DocMuerde/Iot-aquaculture-platform/docs/manuals/latex/Acuacol/Figuras/desmontaje2.jpeg

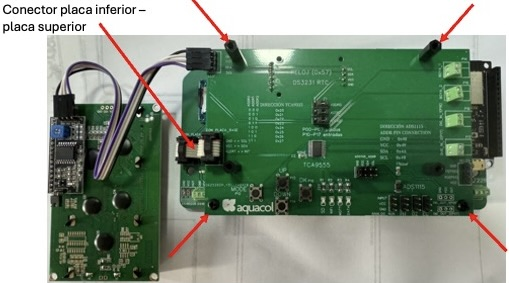
docs/manuals/latex/Acuacol/Figuras/desmontaje2.jpeg
