DocMuerde/Iot-aquaculture-platform/docs/manuals/latex/Acuacol/Figuras/Modulo_reles.png

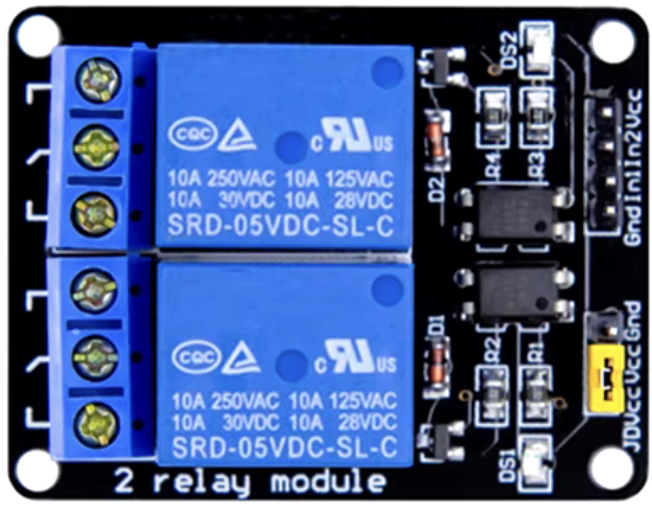
docs/manuals/latex/Acuacol/Figuras/Modulo_reles.png
