DocMuerde/Iot-aquaculture-platform/hardware/pcb1/back1.png

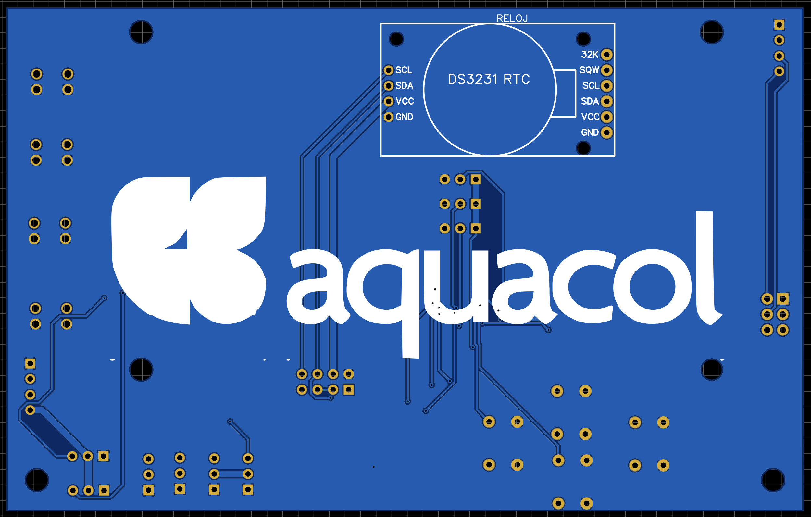
hardware/pcb1/back1.png
