DocMuerde/Iot-aquaculture-platform/hardware/pcb1/front1.png

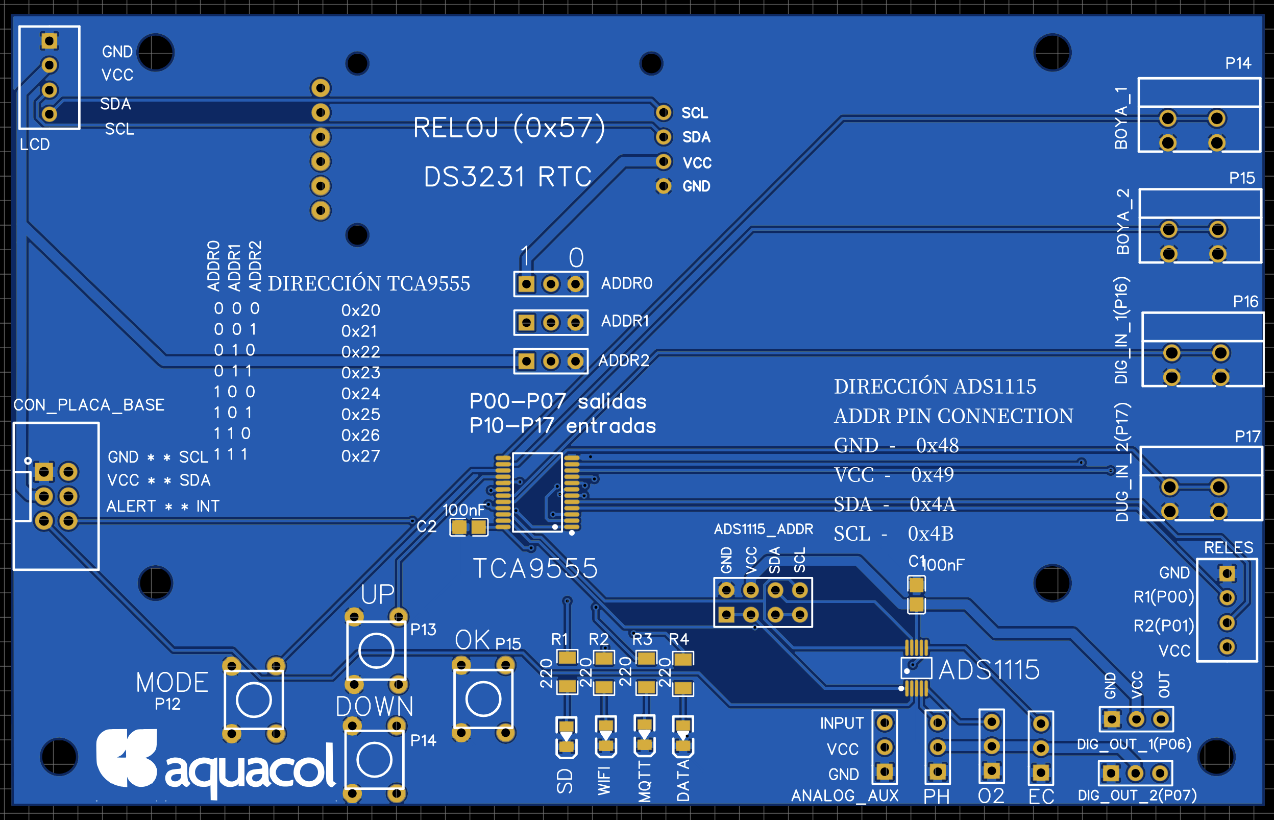
hardware/pcb1/front1.png
