DocMuerde/Iot-aquaculture-platform/hardware/pcb2/back2.png

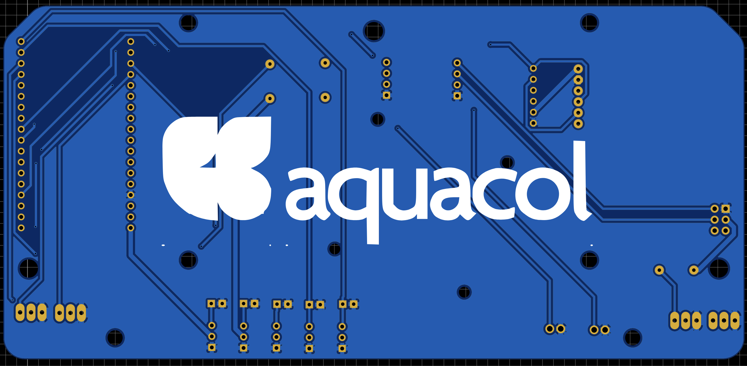
hardware/pcb2/back2.png
