DocMuerde/Iot-aquaculture-platform/hardware/pcb2/front2.png

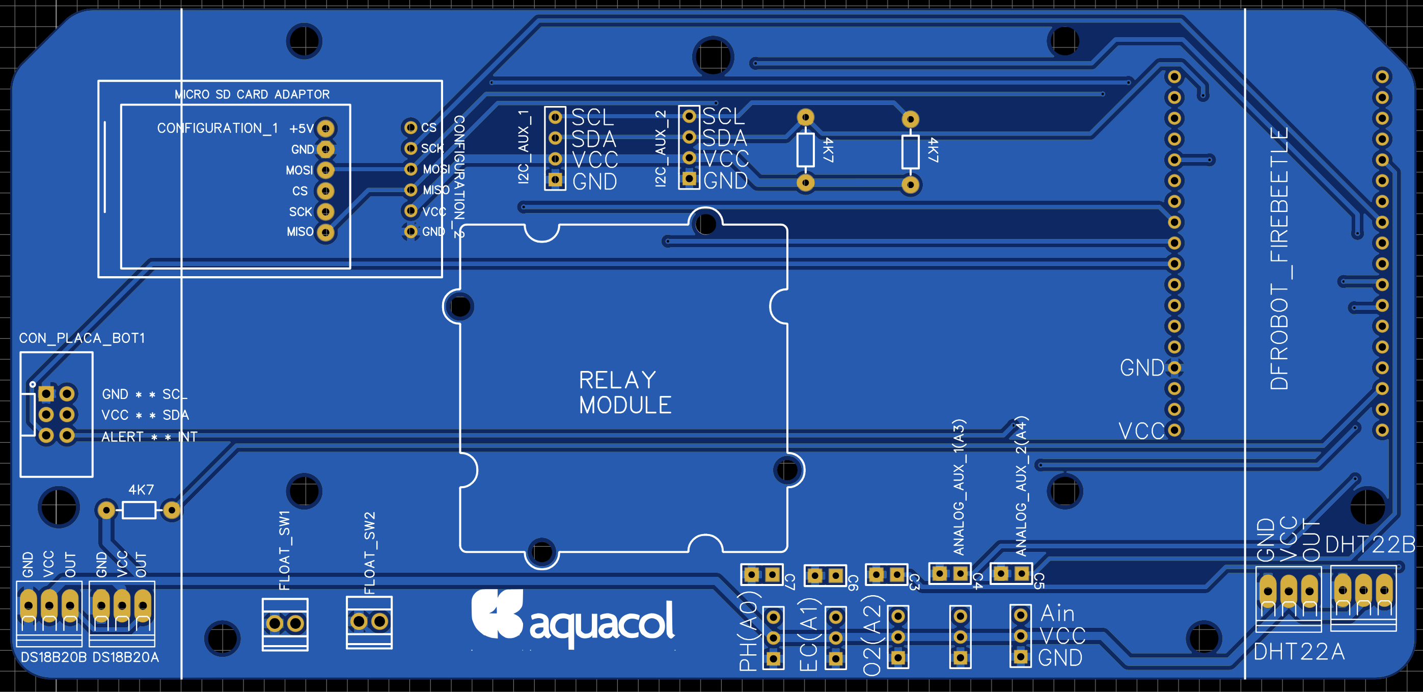
hardware/pcb2/front2.png
