DocMuerde/Iot-aquaculture-platform/hardware/schematics/Schematic_Placa_1_2026-03-30.png

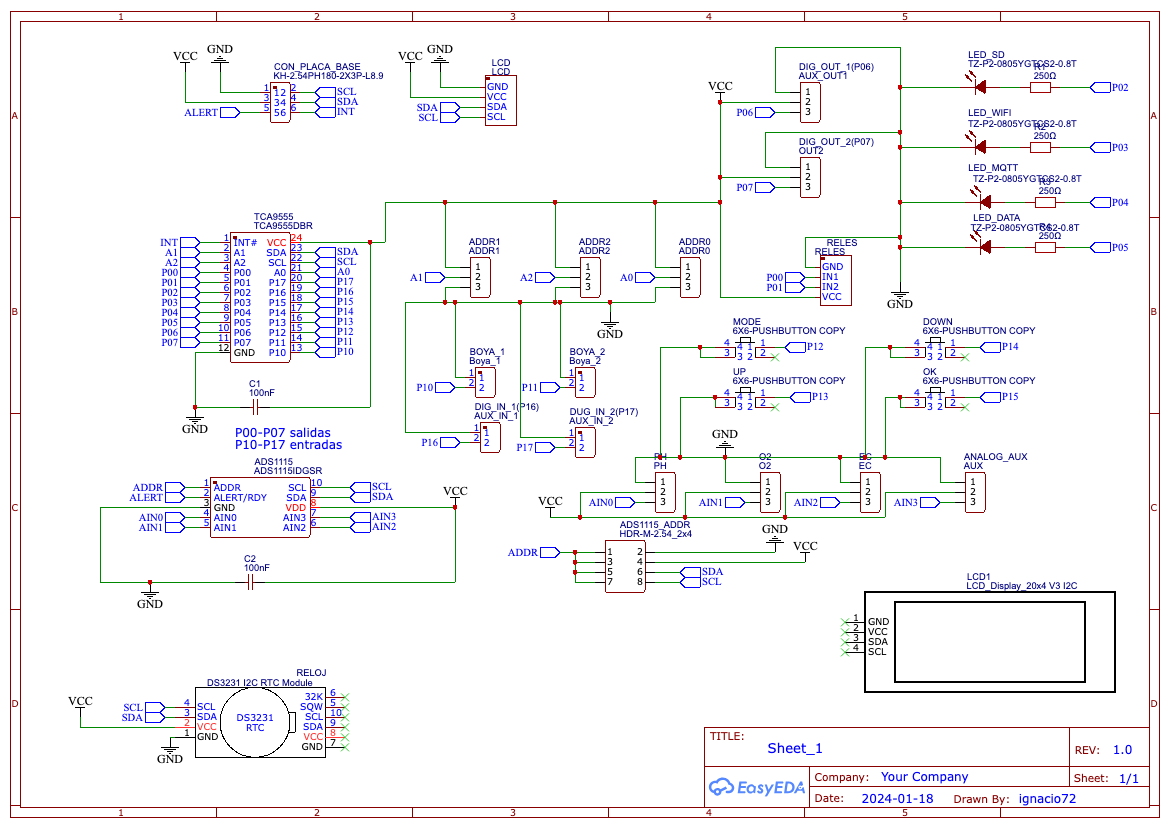
hardware/schematics/Schematic_Placa_1_2026-03-30.png
