DocMuerde/Iot-aquaculture-platform/hardware/schematics/Schematic_Placa_2_2026-03-30.png

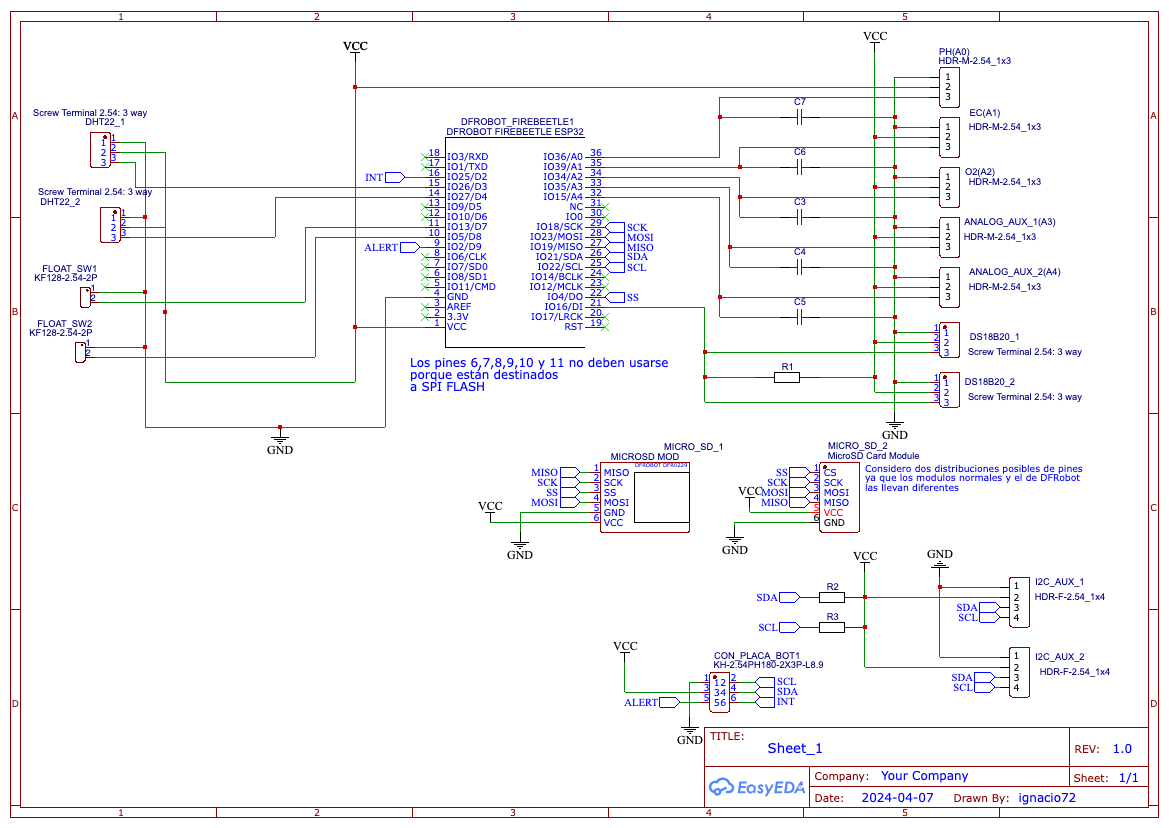
hardware/schematics/Schematic_Placa_2_2026-03-30.png
