DocMuerde/Iot-aquaculture-platform/docs/manuals/latex/Acuacol/portada.tex

%\vspace*{-3cm}
%\begin{minipage}[c]{0.5\textwidth}
%\flushleft{\includegraphics*[width=3.2cm]{Figuras/univer.jpg}}
%\end{minipage}
%\begin{minipage}[c]{.5\textwidth}
%\flushright{\includegraphics*[width=3.2cm]{Figuras/esi.jpg}}
%\end{minipage}

\vspace{10cm}

\begin{Huge}
\begin{center}
MANUAL DEL EQUIPO\\[1cm]
\end{center}
%\vspace{0.5cm}
\end{Huge}
\begin{center}

\begin{figure}[htbp!] 
\centering{\psfig{file=Figuras/ACUACOL.png,width=14cm,angle=0}} 
\end{figure}

%\begin{large}
%Thesis submitted for the Degree of Doctor of Philosophy
%\vspace{1.2cm}
%\end{large}

\begin{large}
\vspace{0.8cm} {\bf Ignacio Alvarado Aldea}\\
\end{large}
%
\vspace{0.4cm} Dpto. de Ingenier\'{\i}a de Sistemas y Autom\'{a}tica\\
%
\vspace{0.4cm} Escuela T\'{e}cnica Superior de Ingenieros\\
%
\vspace{0.4cm} Universidad de Sevilla\\
%
\vspace{0.4cm} Camino de los descubrimientos s/n, 41092, Sevilla\\
%
\vspace{0.4cm} 2024
\vspace{5cm}

%%%%%%%%%%%%%%%%%%%%%
% VERSION
%%%%%%%%%%%%%%%%%%%%%%
%\fbox{ {\Large Versi\'{o}n: 21-05}}

\end{center}
