DocMuerde/Iot-aquaculture-platform/docs/manuals/latex/Acuacol/Figuras/ACUACOL.png

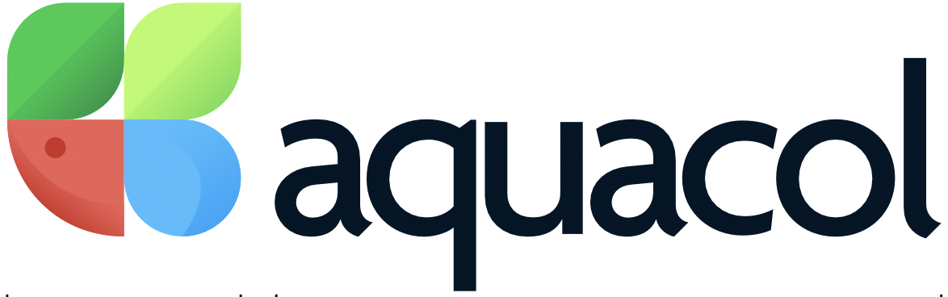
docs/manuals/latex/Acuacol/Figuras/ACUACOL.png
