DocMuerde/Iot-aquaculture-platform/docs/manuals/latex/Acuacol/Figuras/Analog_isolator.jpeg

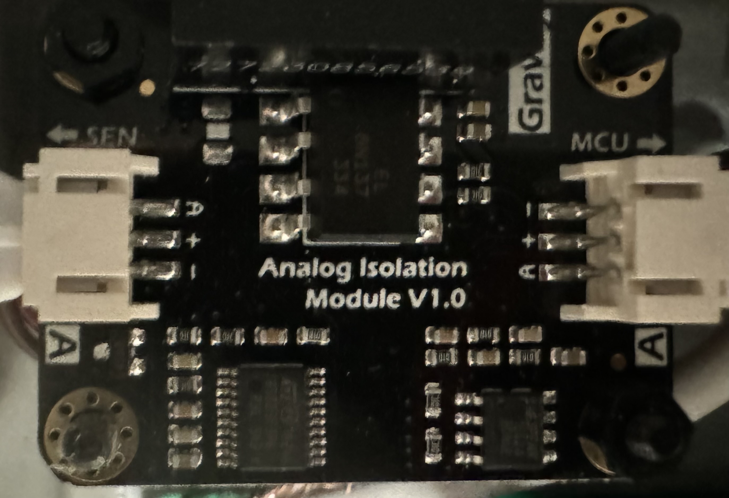
docs/manuals/latex/Acuacol/Figuras/Analog_isolator.jpeg
