DocMuerde/Iot-aquaculture-platform/docs/manuals/latex/Acuacol/Figuras/Botones.jpeg

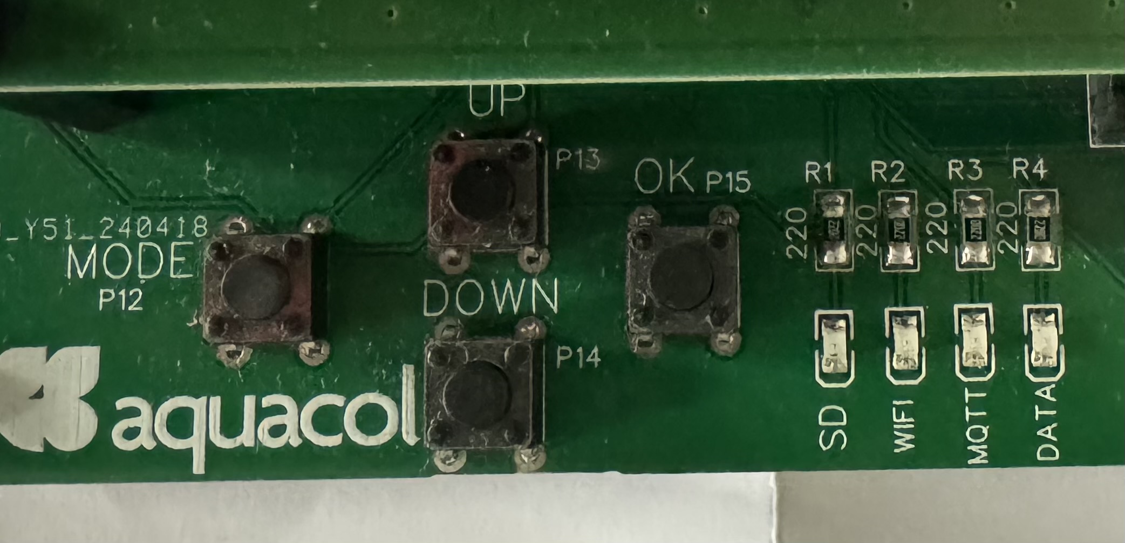
docs/manuals/latex/Acuacol/Figuras/Botones.jpeg
