DocMuerde/Iot-aquaculture-platform/docs/manuals/latex/Acuacol/Figuras/Cables_EC.png

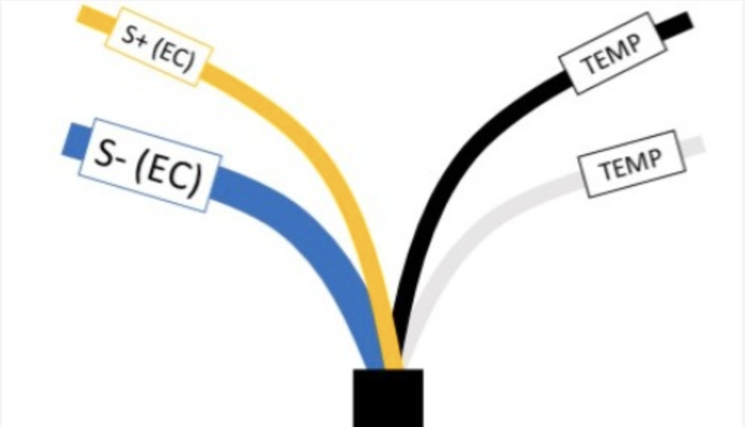
docs/manuals/latex/Acuacol/Figuras/Cables_EC.png
