DocMuerde/Iot-aquaculture-platform/docs/manuals/latex/Acuacol/Figuras/Conf_def.jpeg

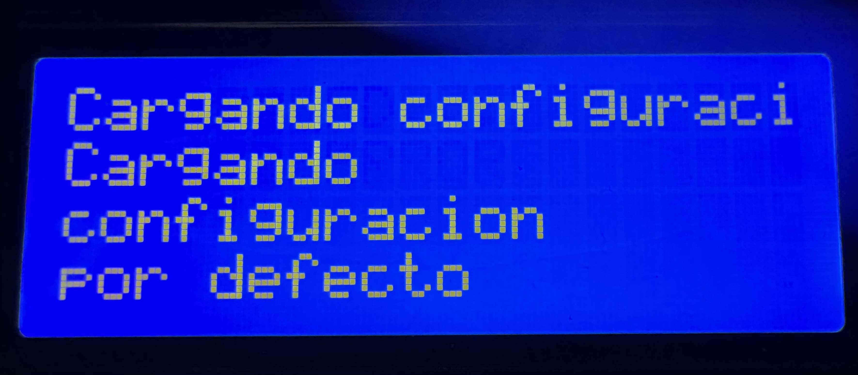
docs/manuals/latex/Acuacol/Figuras/Conf_def.jpeg
