DocMuerde/Iot-aquaculture-platform/docs/manuals/latex/Acuacol/Figuras/desmontaje1.jpeg

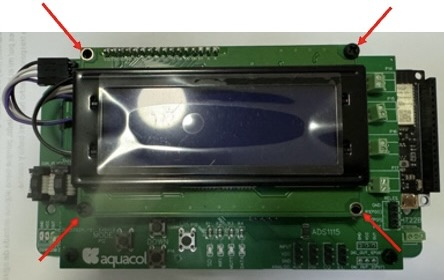
docs/manuals/latex/Acuacol/Figuras/desmontaje1.jpeg
