DocMuerde/Iot-aquaculture-platform/docs/manuals/latex/Acuacol/Figuras/desmontaje3.jpeg

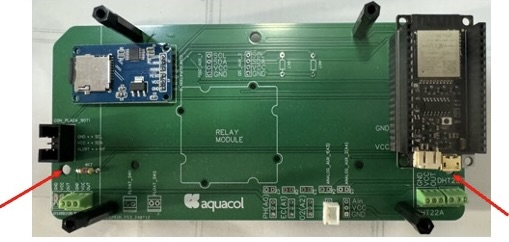
docs/manuals/latex/Acuacol/Figuras/desmontaje3.jpeg
