DocMuerde/Iot-aquaculture-platform/docs/manuals/latex/Acuacol/Figuras/DS18B20.png

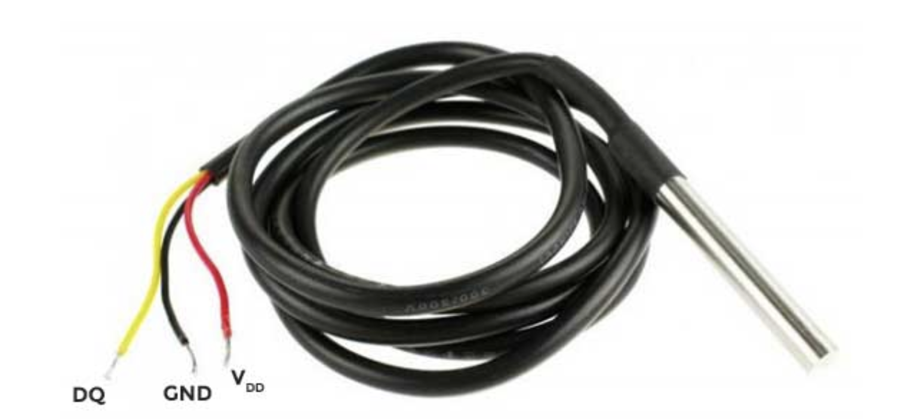
docs/manuals/latex/Acuacol/Figuras/DS18B20.png
