DocMuerde/Iot-aquaculture-platform/docs/manuals/latex/Acuacol/Figuras/DTH22.png

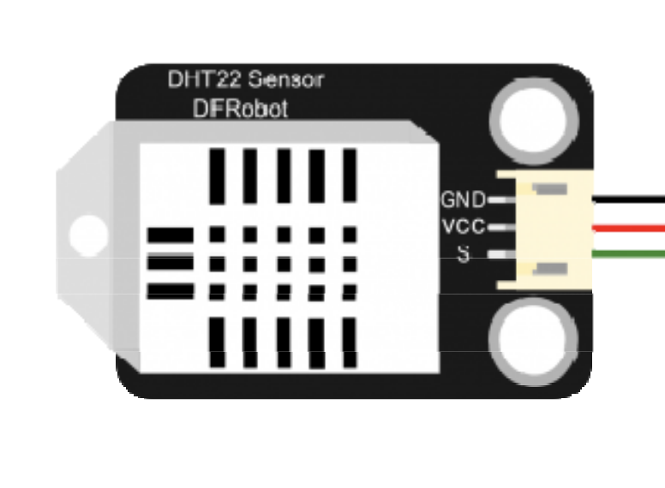
docs/manuals/latex/Acuacol/Figuras/DTH22.png
