DocMuerde/Iot-aquaculture-platform/docs/manuals/latex/Acuacol/Figuras/EC.jpg

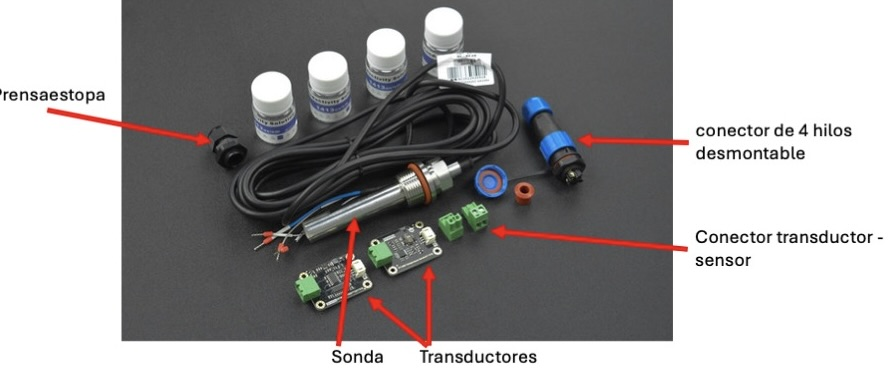
docs/manuals/latex/Acuacol/Figuras/EC.jpg
