DocMuerde/Iot-aquaculture-platform/docs/manuals/latex/Acuacol/Figuras/ECcal.jpeg

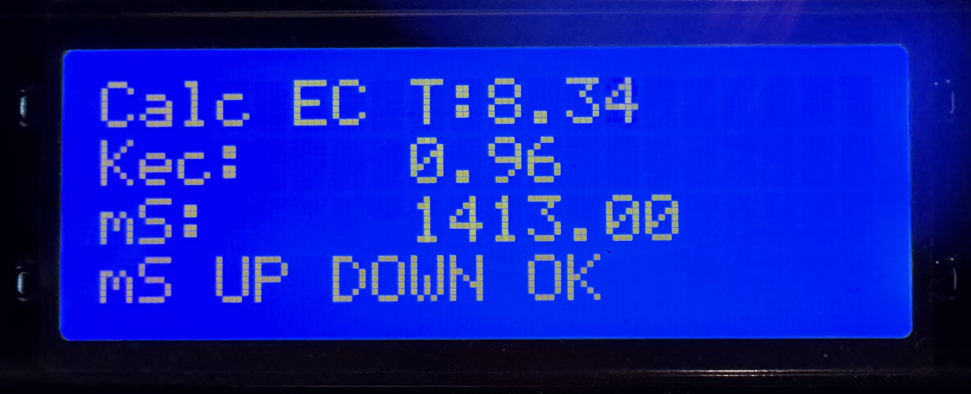
docs/manuals/latex/Acuacol/Figuras/ECcal.jpeg
