DocMuerde/Iot-aquaculture-platform/docs/manuals/latex/Acuacol/Figuras/entradas_analogicas.jpeg

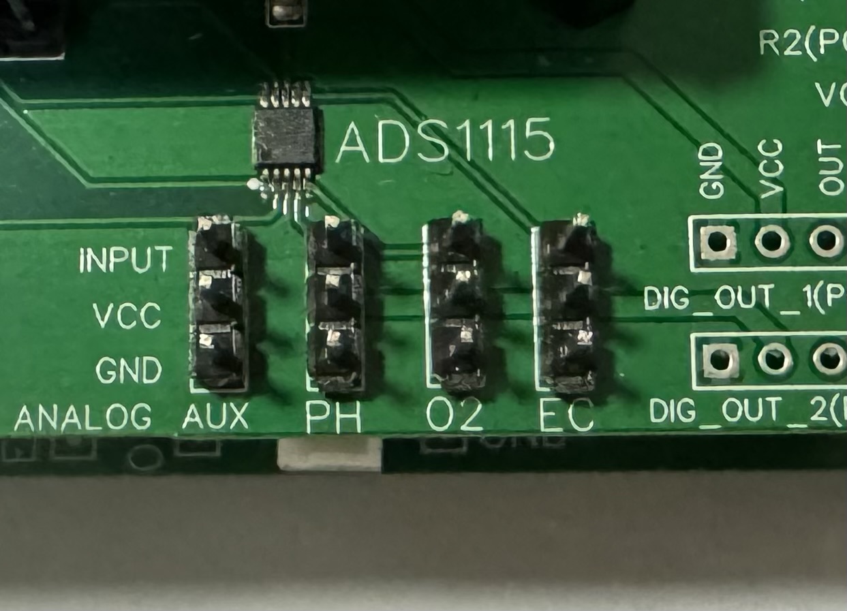
docs/manuals/latex/Acuacol/Figuras/entradas_analogicas.jpeg
