DocMuerde/Iot-aquaculture-platform/docs/manuals/latex/Acuacol/Figuras/esi.jpg

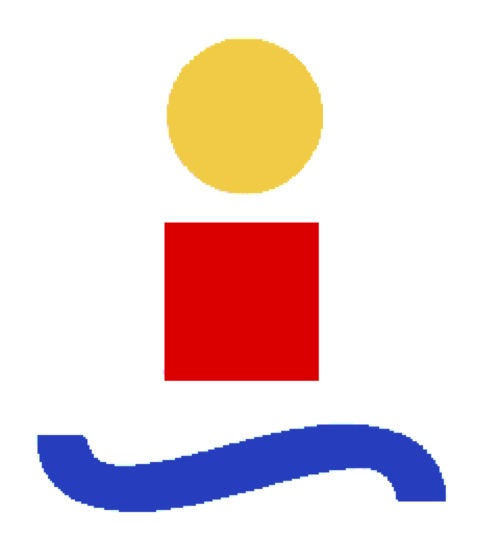
docs/manuals/latex/Acuacol/Figuras/esi.jpg
