DocMuerde/Iot-aquaculture-platform/docs/manuals/latex/Acuacol/Figuras/Kec.jpeg

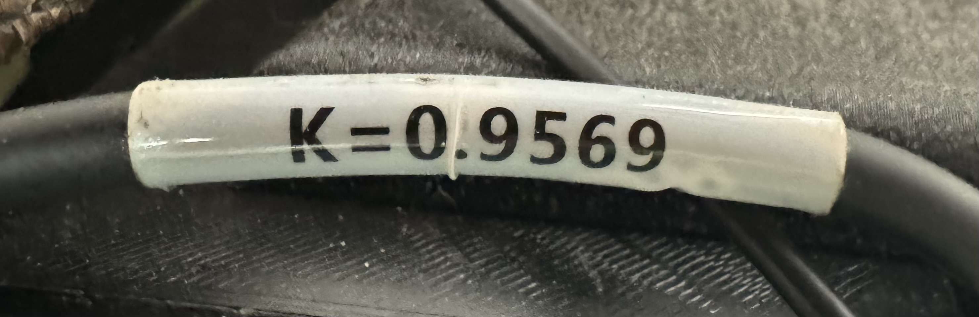
docs/manuals/latex/Acuacol/Figuras/Kec.jpeg
