DocMuerde/Iot-aquaculture-platform/docs/manuals/latex/Acuacol/Figuras/Montaje_Arriba.jpeg

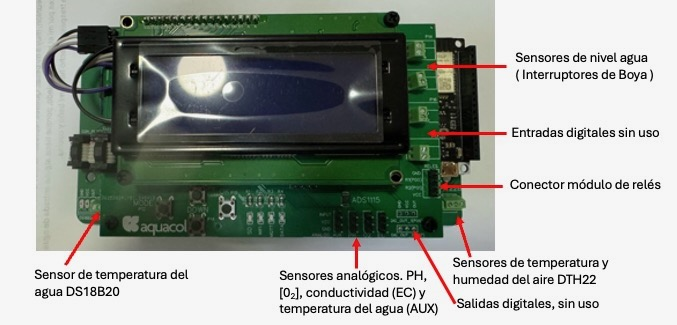
docs/manuals/latex/Acuacol/Figuras/Montaje_Arriba.jpeg
