DocMuerde/Iot-aquaculture-platform/docs/manuals/latex/Acuacol/Figuras/Montaje_derecha.jpeg

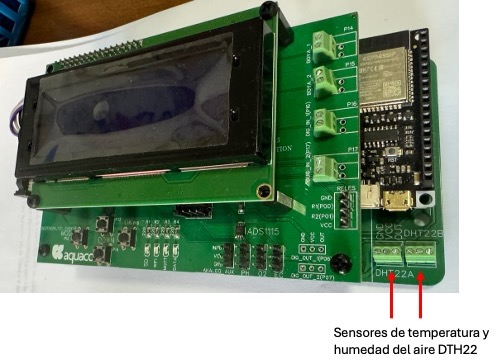
docs/manuals/latex/Acuacol/Figuras/Montaje_derecha.jpeg
