DocMuerde/Iot-aquaculture-platform/docs/manuals/latex/Acuacol/Figuras/Montaje_DS18B20.jpg

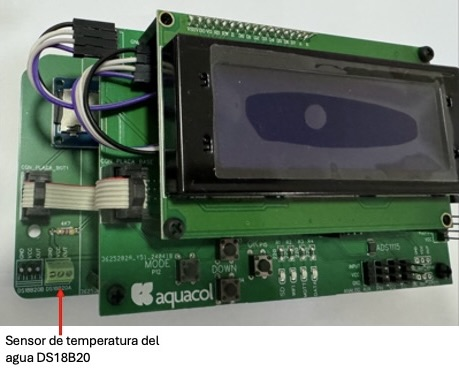
docs/manuals/latex/Acuacol/Figuras/Montaje_DS18B20.jpg
