DocMuerde/Iot-aquaculture-platform/docs/manuals/latex/Acuacol/Figuras/mqtt_ERROR.jpeg

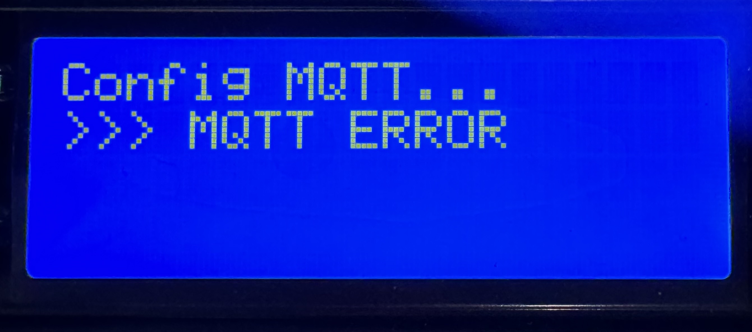
docs/manuals/latex/Acuacol/Figuras/mqtt_ERROR.jpeg
