DocMuerde/Iot-aquaculture-platform/docs/manuals/latex/Acuacol/Figuras/mqtt_ok.jpeg

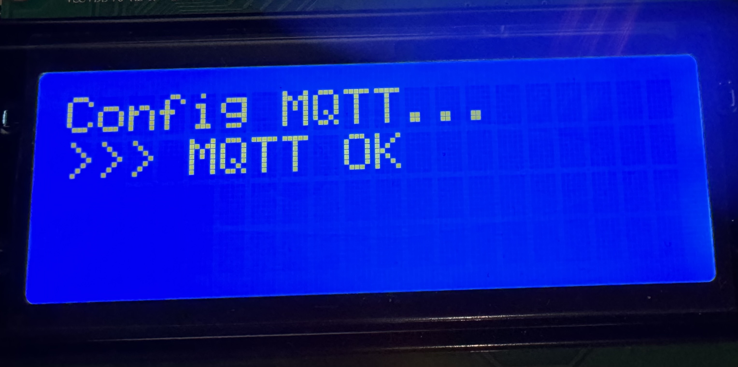
docs/manuals/latex/Acuacol/Figuras/mqtt_ok.jpeg
