DocMuerde/Iot-aquaculture-platform/docs/manuals/latex/Acuacol/Figuras/O2.jpg

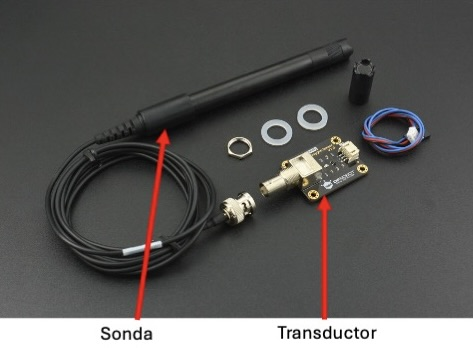
docs/manuals/latex/Acuacol/Figuras/O2.jpg
