DocMuerde/Iot-aquaculture-platform/docs/manuals/latex/Acuacol/Figuras/O2agua.jpeg

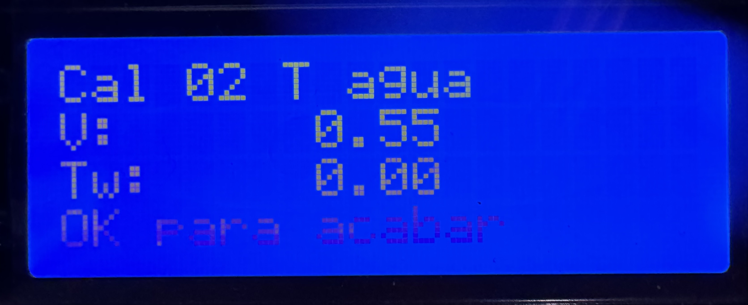
docs/manuals/latex/Acuacol/Figuras/O2agua.jpeg
