DocMuerde/Iot-aquaculture-platform/docs/manuals/latex/Acuacol/Figuras/O2aire.jpeg

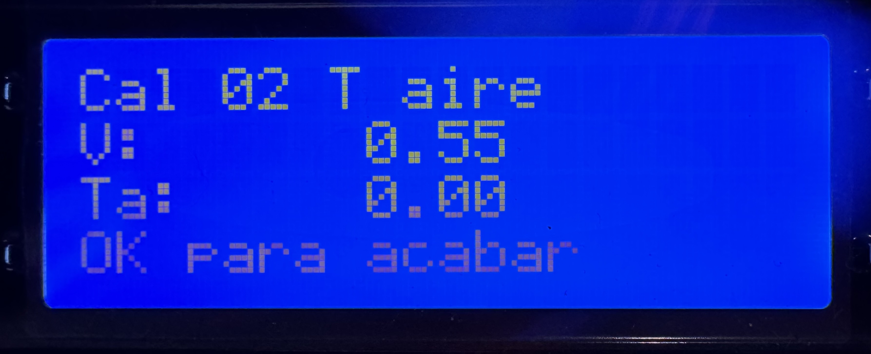
docs/manuals/latex/Acuacol/Figuras/O2aire.jpeg
