DocMuerde/Iot-aquaculture-platform/docs/manuals/latex/Acuacol/Figuras/pantalla1.jpeg

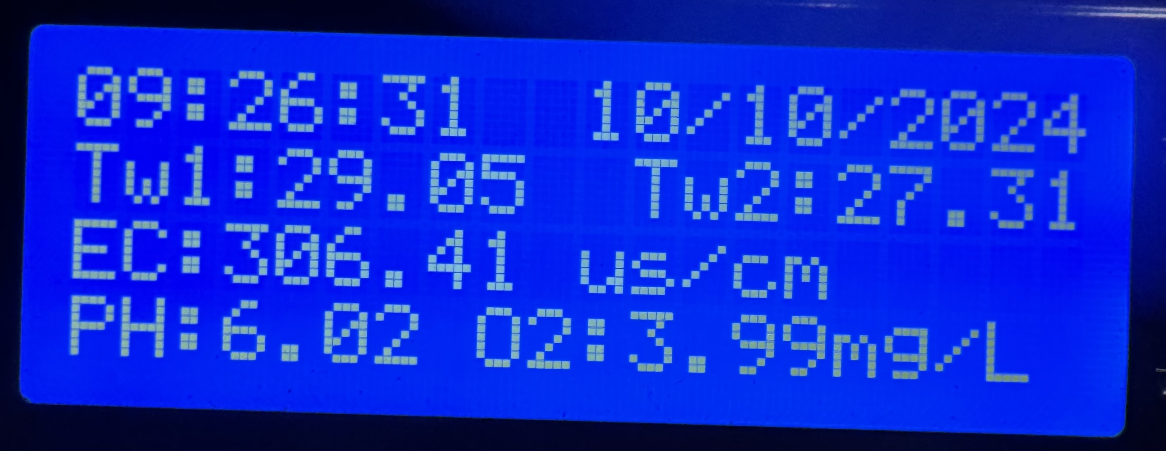
docs/manuals/latex/Acuacol/Figuras/pantalla1.jpeg
