DocMuerde/Iot-aquaculture-platform/docs/manuals/latex/Acuacol/Figuras/pantalla2.jpeg

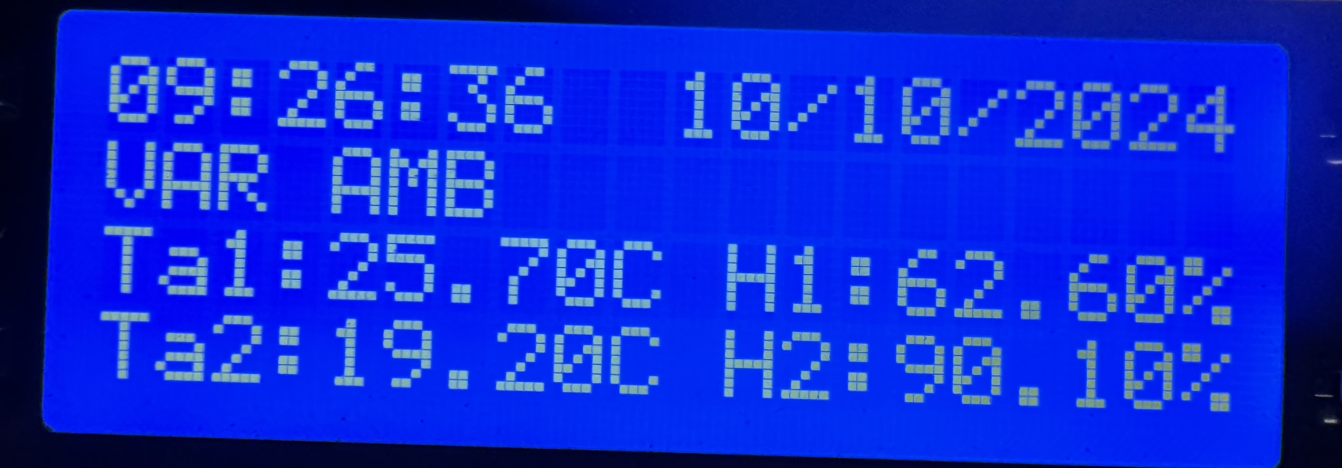
docs/manuals/latex/Acuacol/Figuras/pantalla2.jpeg
