DocMuerde/Iot-aquaculture-platform/docs/manuals/latex/Acuacol/Figuras/PH1.jpeg

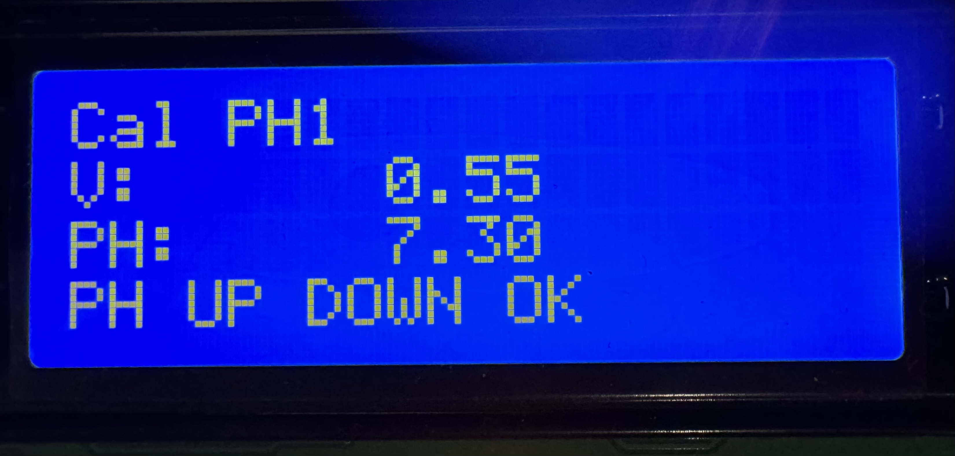
docs/manuals/latex/Acuacol/Figuras/PH1.jpeg
