DocMuerde/Iot-aquaculture-platform/docs/manuals/latex/Acuacol/Figuras/PH2.jpeg

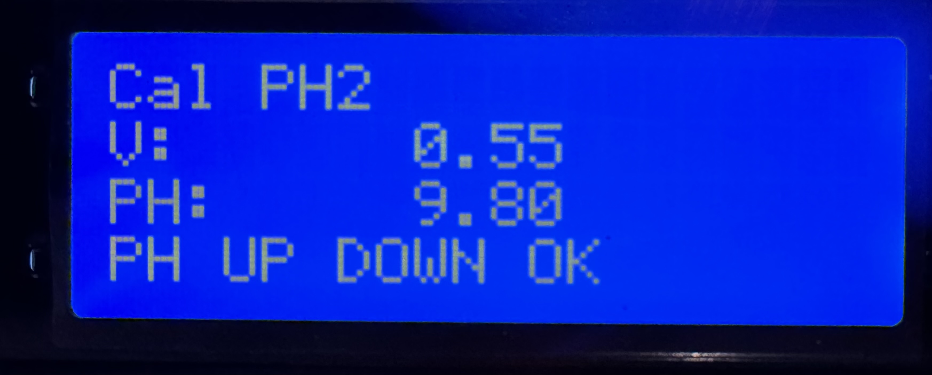
docs/manuals/latex/Acuacol/Figuras/PH2.jpeg
