DocMuerde/Iot-aquaculture-platform/docs/manuals/latex/Acuacol/Figuras/PH.jpg

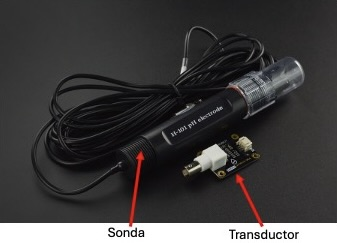
docs/manuals/latex/Acuacol/Figuras/PH.jpg
