DocMuerde/Iot-aquaculture-platform/docs/manuals/latex/Acuacol/Figuras/Reloj_OK.jpeg

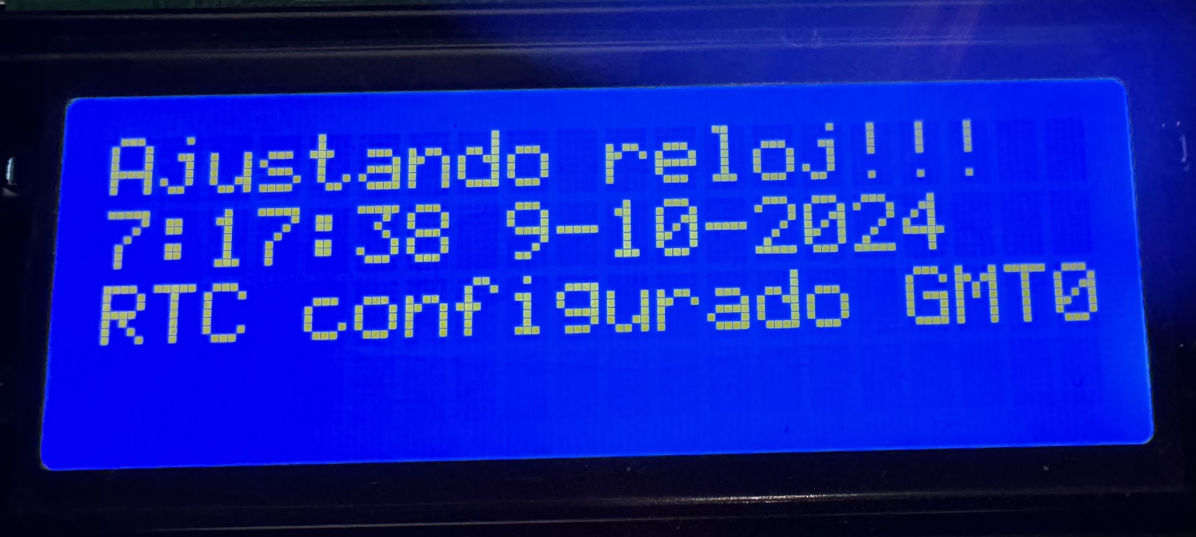
docs/manuals/latex/Acuacol/Figuras/Reloj_OK.jpeg
