DocMuerde/Iot-aquaculture-platform/docs/manuals/latex/Acuacol/Figuras/SD_ERROR.jpeg

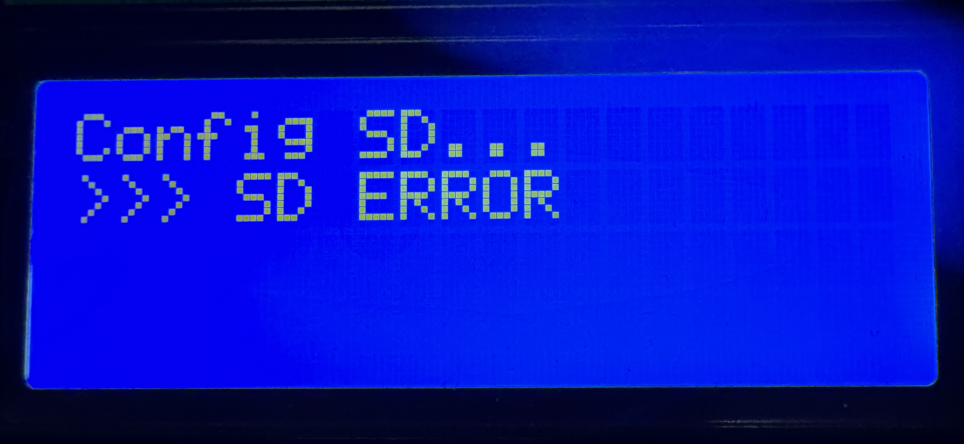
docs/manuals/latex/Acuacol/Figuras/SD_ERROR.jpeg
