DocMuerde/Iot-aquaculture-platform/docs/manuals/latex/Acuacol/Figuras/SD_OK.jpeg

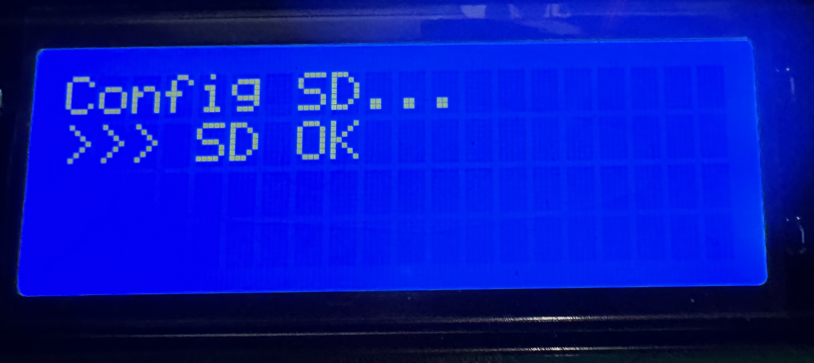
docs/manuals/latex/Acuacol/Figuras/SD_OK.jpeg
