DocMuerde/Iot-aquaculture-platform/docs/manuals/latex/Acuacol/Figuras/sensores_OK.jpeg

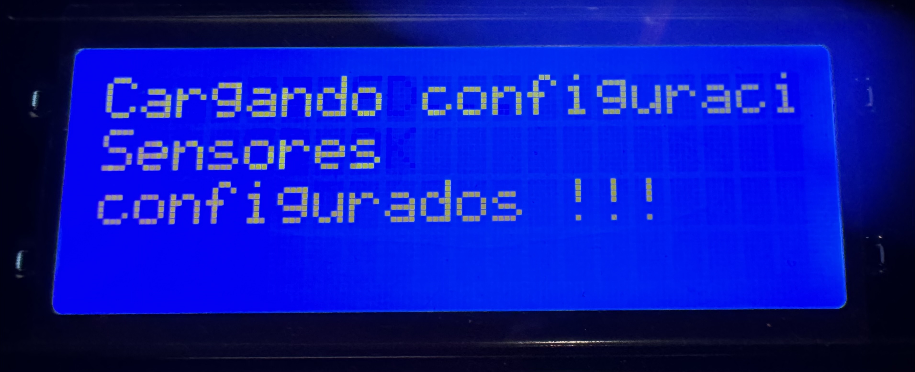
docs/manuals/latex/Acuacol/Figuras/sensores_OK.jpeg
