DocMuerde/Iot-aquaculture-platform/docs/manuals/latex/Acuacol/Figuras/Temperature_transductor.jpeg

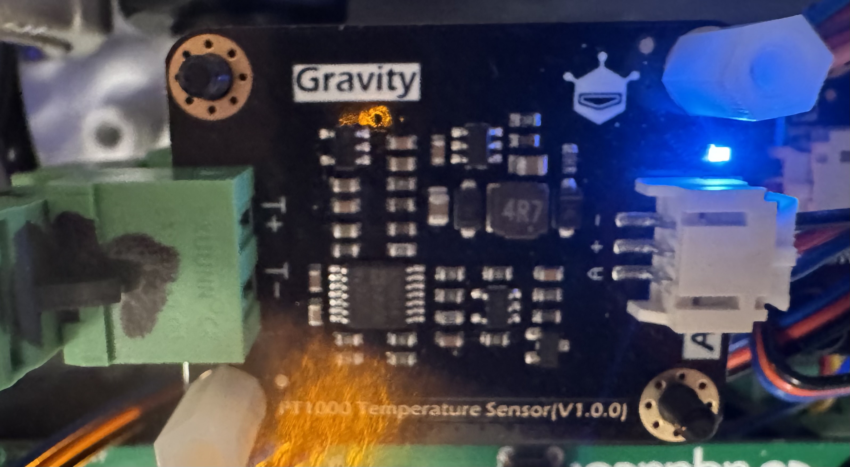
docs/manuals/latex/Acuacol/Figuras/Temperature_transductor.jpeg
