DocMuerde/Iot-aquaculture-platform/docs/manuals/latex/Acuacol/Figuras/univer.jpg

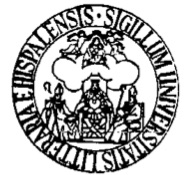
docs/manuals/latex/Acuacol/Figuras/univer.jpg
