DocMuerde/Iot-aquaculture-platform/docs/manuals/latex/Acuacol/Figuras/WIFI_ERROR.jpeg

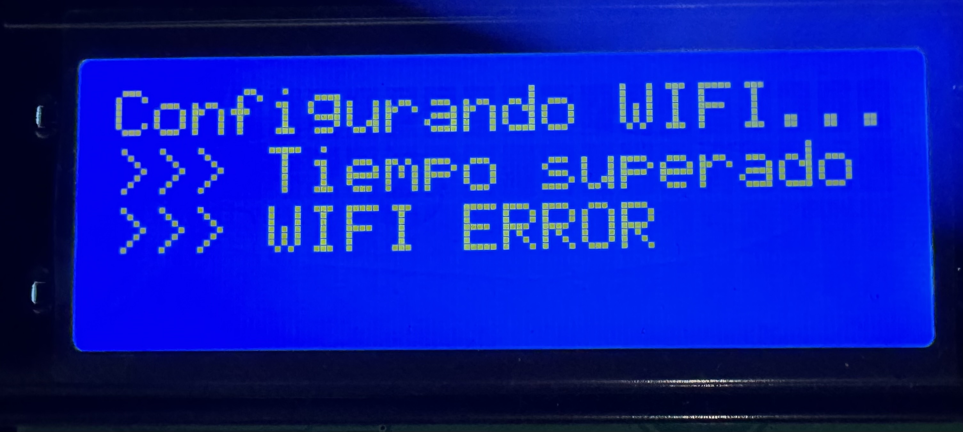
docs/manuals/latex/Acuacol/Figuras/WIFI_ERROR.jpeg
