DocMuerde/Iot-aquaculture-platform/docs/manuals/latex/Acuacol/Figuras/WIFI_OK.jpeg

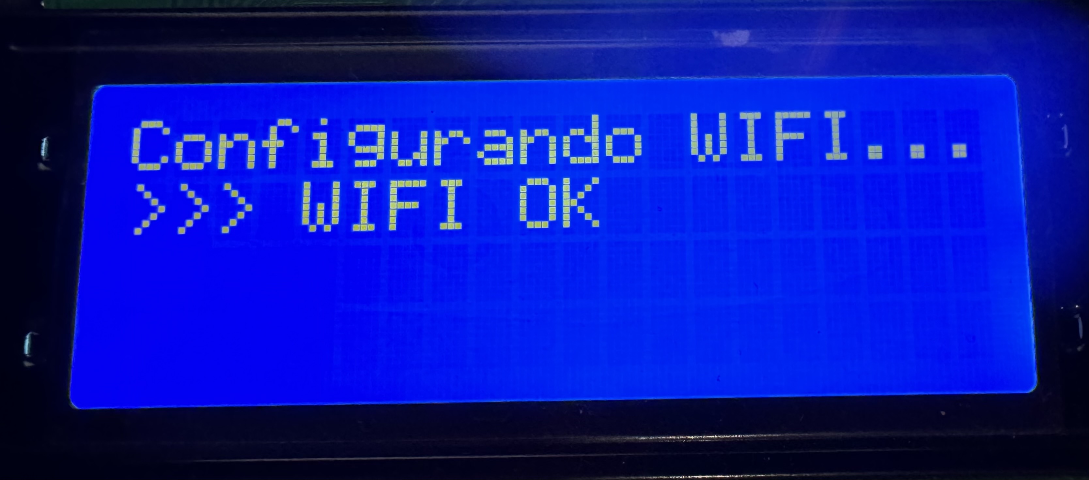
docs/manuals/latex/Acuacol/Figuras/WIFI_OK.jpeg
