DocMuerde/Iot-aquaculture-platform/firmware/esp32-current-version/day_of_year.ino

int calculateDayOfYear(int day, int month, int year) {
  
  // Given a day, month, and year (4 digit), returns 
  // the day of year. Errors return 999.
  
  int daysInMonth[] = {31,28,31,30,31,30,31,31,30,31,30,31};
  
  // Verify we got a 4-digit year
  if (year < 1000) {
    return 999;
  }
  
  // Check if it is a leap year, this is confusing business
  // See: https://support.microsoft.com/en-us/kb/214019
  if (year%4  == 0) {
    if (year%100 != 0) {
      daysInMonth[1] = 29;
    }
    else {
      if (year%400 == 0) {
        daysInMonth[1] = 29;
      }
    }
   }

  // Make sure we are on a valid day of the month
  if (day < 1) 
  {
    return 999;
  } else if (day > daysInMonth[month-1]) {
    return 999;
  }
  
  int doy = 0;
  for (int i = 0; i < month - 1; i++) {
    doy += daysInMonth[i];
  }
  
  doy += day;
  return doy;
}
