DocMuerde/Iot-aquaculture-platform/(commit log)

2026-03-30 Add initial README for PCB hardware
2026-03-30 Add files via upload
    Acuacol manual (first proyect related with the device)
2026-03-30 Revise README with comprehensive project details
    Expanded the README to provide detailed information about the IoT Aquaculture Platform, including system description, repository structure, current implementation, hardware, firmware, documentation, future developments, authors, and license.
2026-03-30 Add README for Main Board v1 with project details
2026-03-30 Revise readme for Board v1 with detailed features
    Expanded the readme to include detailed descriptions of the board's functionalities, features, and components, enhancing clarity for users.
2026-03-30 Update notes on analog sensors requirements
    Removed mention of 'proper signal conditioning' from notes.
2026-03-31 Add readme for Board v2 main controller
    Added detailed description and features for Board v2, including specifications for sensors and future improvements.
2026-03-31 Update README.md with system schematics overview
    Added an overview of the system schematics and details about the main boards.
2026-03-31 Update README with ESP32 firmware details
    Added detailed documentation for the ESP32 firmware, including overview, development environment, main architecture, and functionalities.
2026-03-31 Add START_HERE.md for firmware setup instructions
    This document outlines the steps to compile, upload, and run the current firmware version for the IoT aquaculture platform, including environment setup, required libraries, project structure, configuration, setup sequence, main loop behavior, pH control system, important notes, known limitations, and future plans.
2026-04-27 fix: update AGROSENTINEL_URL to production Render endpoint
    [config_agrosentinel.h]
2026-05-04 Add sequence_id_generator (fix missing dependency for AgroSentinel)
    [sequence_id_generator.ino]
